ggannann/utca-rtm-8-sfp-hw/DOC/top.png

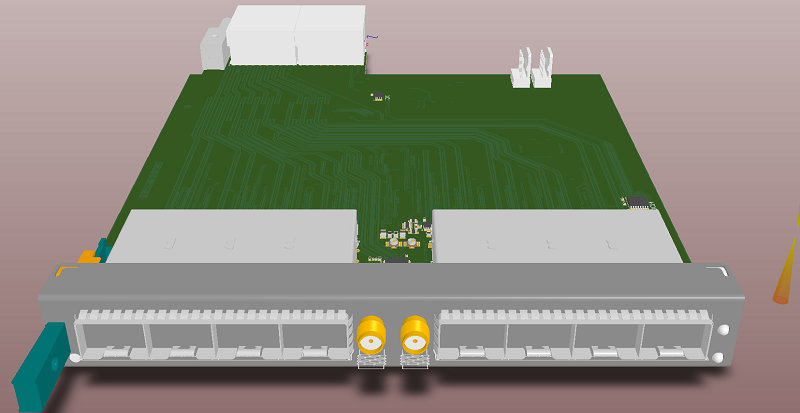
DOC/top.png
