ggannann/utca-rtm-8-sfp-hw/circuit_board/BOM_RTM_SFP.xls

Já comprado | Quantity | Comment | Description | Designator | Footprint | LibRef | Manufacturer Part Number 1 | Manufacturer1 PN | Part Description | Part Number | Value
ok | 51 | 100nF | CC0402_100NF_16V_10%_X7R | C1, C2, C3, C4, C5, C6, C7, C8, C16, C17, C18, C19, C20, C21, C22, C23, C25, C26, C27, C186A, C186B, C186C, C186D, C186E, C186F, C186G, C186H, C202A, C202B, C202C, C202D, C202E, C202F, C202G, C202H, C214A, C214B, C214C, C214D, C214E, C214F, C214G, C214H, C228A, C228B, C228C, C228D, C228E, C228F, C228G, C228H | CAPC1005X55N | 223878715649 |  |  | SMD Multilayer Chip Ceramic Capacitor | CC0402_100NF_16V_10%_X7R | 100nF
comprando | 4 | 10uF | CC1206_10UF_16V_10%_X7R | C9, C10, C12, C14 | CAPC3216X140N | C1206C106K4RAC |  |  | SMD Multilayer Chip Ceramic Capacitor | CC1206_10UF_16V_10%_X7R | 10uF
ok | 2 | 100nF | CC0603_100NF_50V_10%_X7R | C11, C280 | CAPC1608X87N | 223858615649 |  |  | SMD Multilayer Chip Ceramic Capacitor | CC0603_100NF_50V_10%_X7R | 100nF
ok | 26 | 10uF | CC0805_10UF_10V_10%_X7R | C13A, C13B, C13C, C13D, C13E, C13F, C13G, C13H, C24, C219A, C219B, C219C, C219D, C219E, C219F, C219G, C219H, C220A, C220B, C220C, C220D, C220E, C220F, C220G, C220H, C390 | CAPC2012X135N | GRM21BR71A106KE51L |  |  | SMD Multilayer Chip Ceramic Capacitor | CC0805_10UF_10V_10%_X7R | 10uF
ok | 11 | 22uF | CC1206_22UF_10V_10%_X7R | C15, C176, C179, C180, C181, C182, C207, C208, C209, C210, C213 | CAPC3216X180N | GRM31CR71A226KE15L |  |  | SMD Multilayer Chip Ceramic Capacitor | CC1206_22UF_10V_10%_X7R | 22uF
ok | 2 | 1uF | CC0603_1UF_16V_10%_X7R | C84, C386 | CAPC1608X87N | 223824613663 |  |  | SMD Multilayer Chip Ceramic Capacitor | CC0603_1UF_16V_10%_X7R | 1uF
ok | 12 | 100nF | CC0201_100NF_6.3V_10%_X5R | C391, C392, C393, C394, C395, C396, C397, C399, C400, C401, C402, C403 | CAPC0603X33N | 02016D104KAT2A |  |  | SMD Multilayer Chip Ceramic Capacitor | CC0201_100NF_6.3V_10%_X5R | 100nF
comprando | 2 | SFP+ | SFP+ 1x4 Cage (46 Pins) | Cage1, Cage2 | TYCO_2007132-1 | TYCO_2007132-1 |  |  | 1x4 Press Fit Cage For Use with SFP+ Connector (Small Form-factor Pluggable) | TYCO_2007132-1
comprando | 1 | 1.5A-15V | Fuse | F1 | FUSR_TYCO_SMD150F-2 | FUSR_TYCO_SMD150F-2 |  |  | PolySwitch® PTC Overcurrent Protection Device | FUSR_TYCO_SMD150F-2 | 1.5A-15V
comprando | 1 | 74HC04D | Hex Inverter | IC1 | SOIC127P600X175-14N | 74HC04D |  |  | Hex Inverters | 74HC04D
comprando | 4 | 74HC165D | 8-Bit Parallel-In/Serial Out Shift Register | IC2, IC5, IC7, IC9 | SOIC127P600X175-16N | 74HC165D |  |  | 8-Bit Parallel-In/Serial Out Shift Register | 74HC165D
comprando | 5 | 74HC4094D | shift register | IC3, IC4, IC6, IC8, IC10 | SO-16 | 4094
comprando | 1 | CDCLVD1212RHAT | Low Jitter, 2-Input Selectable 1:12 Universal-to-LVDS Buffer | IC11 | QFN50P600-40 | CLOCK_CDCLVD1212
comprando | 2 | LM75AIM | I2C temperature sensor | IC12, IC13 | SOIC127P600X175-8N | SENS_LM75
comprando | 1 | PCA9554DB | 8-bit I2C-bus SMBus I/O port with interrupt | IC14 | SOP65P640X120-16N | PCA9554D | NXP Semiconductors | PCA9554D,112
comprando | 1 | 24LC64-I/MS | 64K I2C Serial EEPROM | IC15 | SOP65P490X110-8N | 24LC64-I/MS |  |  | 2.5V-5.5V, 64K (8K x 8-bit) I2C Serial EEPROM | 24LC64-I/MS
comprando | 1 | TPS53126RGET | Dual Synchronous Step-Down Controller For Low Voltage Power Rails | IC16 | QFN50P400X400X100-25N-S255 | TPS53126RGET |  |  | Dual Synchronous Step-Down Controller For Low Voltage Power Rails | TPS53126RGET
comprando | 8 | nm | High-Speed Differential Line Receiver | IC20A, IC20B, IC20C, IC20D, IC20E, IC20F, IC20G, IC20H | SOT95P280X145-5N | SN65LVDS2DBVR |  |  | High-Speed Differential Line Receiver | SN65LVDS2DBVR
comprando | 1 | MAX7357ETG+ | 8-channel I2C-bus multiplexer with reset, INT and timeout | IC39 | HVQFN24 | IIC_MUX_MAX7357ETG+
comprando | 1 | FIN1101K8X | LVDS TO LVDS repeater3.3V | IC48 | US8 | IFC_FIN1101K8X
comprando | 1 | Family | Single Pin Male | J1 | TYCO_1469265-1 | TYCO_1469265-1 |  |  |  | TYCO_1469265-1
comprando | 2 | Family | Connector 60 ATCA Male 30 Pairs (60 Signals) + 3x10 Ground | J2, J6 | TYCO_6469183-1 | TYCO_6469183-1 |  |  |  | TYCO_6469183-1
comprando | 2 | SMA |  | J3, J4 | HUBER-SUHNER_85 SMA-50-0-101/111 NE | HUBER-SUHNER_85_SMA-50-0-101/111_NE |  |  | SMA 50 Ohms Right Angle PCB Jack | HUBER-SUHNER_85_SMA-50-0-101/111_NE
comprando | 8 | SFP+ | 20 Position SFP+ Connector (Small Form-factor Pluggable) | J5A, J5B, J5C, J5D, J5E, J5F, J5G, J5H | TYCO_1888247-1 | TYCO_1888247-1 |  |  | 20 Position, Pitch 0.8mm SFP+ Receptacle (Small Form-factor Pluggable) | TYCO_1888247-1
comprando | 2 | U.FL |  | J12, J13 | HIROSE_U.FL-R-SMT-1(10) | HIROSE_U.FL-R-SMT-1(10) |  |  | Up to 6GHz Ultra Small Surface Mount Male Coaxial Connectors U.FL Series | HIROSE_U.FL-R-SMT-1(10)
comprando | 2 | 1.5uH | Inductor With Magnetic core | L1, L2 | INDM6965X300N | IND2525_1.5UH_20%_VISHAY_IHLP-2525CZ |  |  | Low Profile, High Current IHLP® Inductor | IND2525_1.5UH_20%_VISHAY_IHLP-2525CZ | 1.5uH
ok | 16 | 220R@100MHz | Inductor | L5A, L5B, L5C, L5D, L5E, L5F, L5G, L5H, L11A, L11B, L11C, L11D, L11E, L11F, L11G, L11H | INDC2012X105N | IND0805_MURATA_BLM21PG221SN1D |  |  | SMD EMIFIL Suppression Chip Ferrite Bead | IND0805_MURATA_BLM21PG221SN1D | 220R@100MHz
comprando | 2 | 390R@100MHz | Inductor | L19, L20 | INDC1608X95N | IND0603_TDK_MPZ1608R391A |  |  | SMT Chip Bead for Power Line | IND0603_TDK_MPZ1608R391A | 390R@100MHz
comprando | 9 | Green | LED Green Avago C120 | LD1A, LD1B, LD1C, LD1D, LD1E, LD1F, LD1G, LD1H, LDx | LED_AVAGO_HSME-C120 | HSME-C120 |  |  | High Performance Right Angle Chip Green LED | LED_AVAGO_HSME-C120
comprando | 8 | Red | LED Red Avago C120 | LD2A, LD2B, LD2C, LD2D, LD2E, LD2F, LD2G, LD2H | LED_AVAGO_HSME-C120 | HSMC-C120 |  |  | High Performance Right Angle Chip Red LED | LED_AVAGO_HSMC-C120
comprando | 1 | Blue | LED Blue Avago C120 | LDy | LED_AVAGO_HSME-C120 | HSMR-C120 |  |  | High Performance Right Angle Chip Blue LED | LED_AVAGO_HSMR-C120
comprando | 1 | LED0603-P-RW120 or LYN971-Z | LED 0603 red | LED17 | led_0603R | LED_0603R | DIALIGHT
ok | 1 | 570BBC000121DG | Any-Rate I2C Programmable XO Oscillator Si570 Serie | OSC1 | OSC_SILICON-LAB_SI570 | OSC_10-280MHZ_SILICON-LAB_Si570BBC000121DG |  |  | 10-280MHz 3.3V ±20ppm LVDS Any-Rate I2C Programmable XO Oscillator Si570 Serie | OSC_10-280MHZ_SILICON-LAB_Si570BBC000121DG | 100MHz
comprando | 1 | Push Button | Push-Button Switch SPDT | PB1 | SW_C&K_HDT0001 | SW_C&K_HDT0001 |  |  | 5VDC 1mA SPST-NO Micro Mini Surface Surface Mount Detect Push-Button Switch, HDT Serie | SW_C&K_HDT0001
comprando | 19 | 330 | R0603_330R_1%_0.1W_100PPM | R1A, R1B, R1C, R1D, R1E, R1F, R1G, R1H, R7, R8, R9, R11A, R11B, R11C, R11D, R11E, R11F, R11G, R11H | RESC1608X55N | NRC06F3300TRF |  |  | General Purpose Thick Film Chip Resistor | R0603_330R_1%_0.1W_100PPM | 330
 | 6 | 100k | RES SMD 100K OHM 0.1% 1/16W 0603 | R2, R3, R4, R5, R6, R13 | RESC1608X55N | RN73C1J100KBTDF | TT Electronics/Welwyn | PCF0603R-100KBT1 | General Purpose Thick Film Chip Resistor | RES SMD 100K OHM 0.1% 1/16W 0603 | 100k
comprando | 16 | 100 | R0603_100R_1%_0.1W_100PPM | R105A, R105B, R105C, R105D, R105E, R105F, R105G, R105H, R109A, R109B, R109C, R109D, R109E, R109F, R109G, R109H | RESC1608X55N | NRC06F4700TRF |  |  | General Purpose Thick Film Chip Resistor | R0603_100R_1%_0.1W_100PPM | 100
ok | 40 | 10k | R0603_10K_1%_0.1W_100PPM | R10A, R10B, R10C, R10D, R10E, R10F, R10G, R10H, R12A, R12B, R12C, R12D, R12E, R12F, R12G, R12H, R400A, R400B, R400C, R400D, R400E, R400F, R400G, R400H, R403A, R403B, R403C, R403D, R403E, R403F, R403G, R403H, R404A, R404B, R404C, R404D, R404E, R404F, R404G, R404H | RESC1608X55N | NRC06F1002TRF |  |  | General Purpose Thick Film Chip Resistor | R0603_10K_1%_0.1W_100PPM | 10k
ok | 29 | 10k | R0402_10K_1%_0.0625W_100PPM | R14, R15, R16, R28, R30, R31, R32, R311, R316, R317, R318, R319, R320, R321, R322, R323, R324, R325, R326, R327, R328, R329, R330, R331, R332, R333, R334, R335, R336 | RESC1005X40N | 232270671003L |  |  | General Purpose Thick Film Chip Resistor | R0402_10K_1%_0.0625W_100PPM | 10k
comprando | 2 | 6k8 1% | R0603_6K8_1%_0.1W_100PPM | R17, R195 | 0603R | NRC06F6801TRF |  |  | General Purpose Thick Film Chip Resistor | R0603_6K8_1%_0.1W_100PPM | 6k8
comprando | 2 | 1k3 1% | R0603_1K3_1%_0.1W_100PPM | R18, R54 | 0603R | NRC06F1301TRF |  |  | General Purpose Thick Film Chip Resistor | R0603_1K3_1%_0.1W_100PPM | 1k3
comprando | 4 | 1M | R1206_1M_1%_0.25W_100PPM | R19, R20, R21, R22 | RESC3216X65N | NRC12F1004TRF |  |  | General Purpose Thick Film Chip Resistor | R1206_1M_1%_0.25W_100PPM | 1M
ok | 6 | 5k1 | R0603_5K1_1%_0.1W_100PPM | R23, R24, R25, R26, R27, R246 | RESC1608X55N | NRC06F5101TRF |  |  | General Purpose Thick Film Chip Resistor | R0603_5K1_1%_0.1W_100PPM | 5k1
comprando | 4 | 100R | R0603_5K1_1%_0.1W_100PPM | R33, R34, R35, R36 | RESC1608X55N | NRC06F5101TRF |  |  | General Purpose Thick Film Chip Resistor | R0603_5K1_1%_0.1W_100PPM | 100R
comprando | 1 | 4k3 1% | R0603_4K3_1%_0.1W_100PPM | R53 | 0603R | NRC06F4301TRF |  |  | General Purpose Thick Film Chip Resistor | R0603_4K3_1%_0.1W_100PPM | 4k3
comprando | 8 | 0 | R0603_0R_JUMPER | R107A, R107B, R107C, R107D, R107E, R107F, R107G, R107H | RESC1608X55N | NRC06Z0 |  |  | 1A (0.05R Max DC Resistance) Zero Ohm Jumper | R0603_0R_JUMPER | 0
ok | 1 | 51R | SMD Resistor | R211 | 0402R | CRCW04021K00JNED | VISHAY
comprando | 1 | 3k0 1% | R0603_3K_1%_0.1W_100PPM | R248 | 0603R | NRC06F3001TRF |  |  | General Purpose Thick Film Chip Resistor | R0603_3K_1%_0.1W_100PPM | 3k
ok | 4 | 49R9 | R0402_49R9_1%_0.0625W_100PPM | R312, R313, R314, R315 | RESC1005X40N | 232270674999L or RC0402FR-0749R9L |  |  | General Purpose Thick Film Chip Resistor | R0402_49R9_1%_0.0625W_100PPM | 49R9
comprando | 1 | 4k3 | R0603_4K3_1%_0.1W_100PPM | R391 | RESC1608X55N | NRC06F4301TRF |  |  | General Purpose Thick Film Chip Resistor | R0603_4K3_1%_0.1W_100PPM | 4k3
ok | 16 | BSS138LT1G | N-CHANNEL MOSFET WITH DIODE | T1A, T1B, T1C, T1D, T1E, T1F, T1G, T1H, T2A, T2B, T2C, T2D, T2E, T2F, T2G, T2H | SOT95P240X110-3N | BSS138LT1G |  |  | 50V 200mA N-Channel Enhancement Mode Field-Effect Transistor | BSS138LT1G
comprando | 2 | IRF9910Pbf | Dual SO-8 MOSFET For POL Cconverter | T5, T6 | SOIC127P600X175-8N | IRF9910Pbf |  |  | 20V 10A(Q1) 20V 12A (Q2) Dual SO-8 MOSFET For POL Cconverter | IRF9910Pbf
