ggannann/utca-rtm-8-sfp-hw/DOC/SCH_uTCA_SFP.PDF

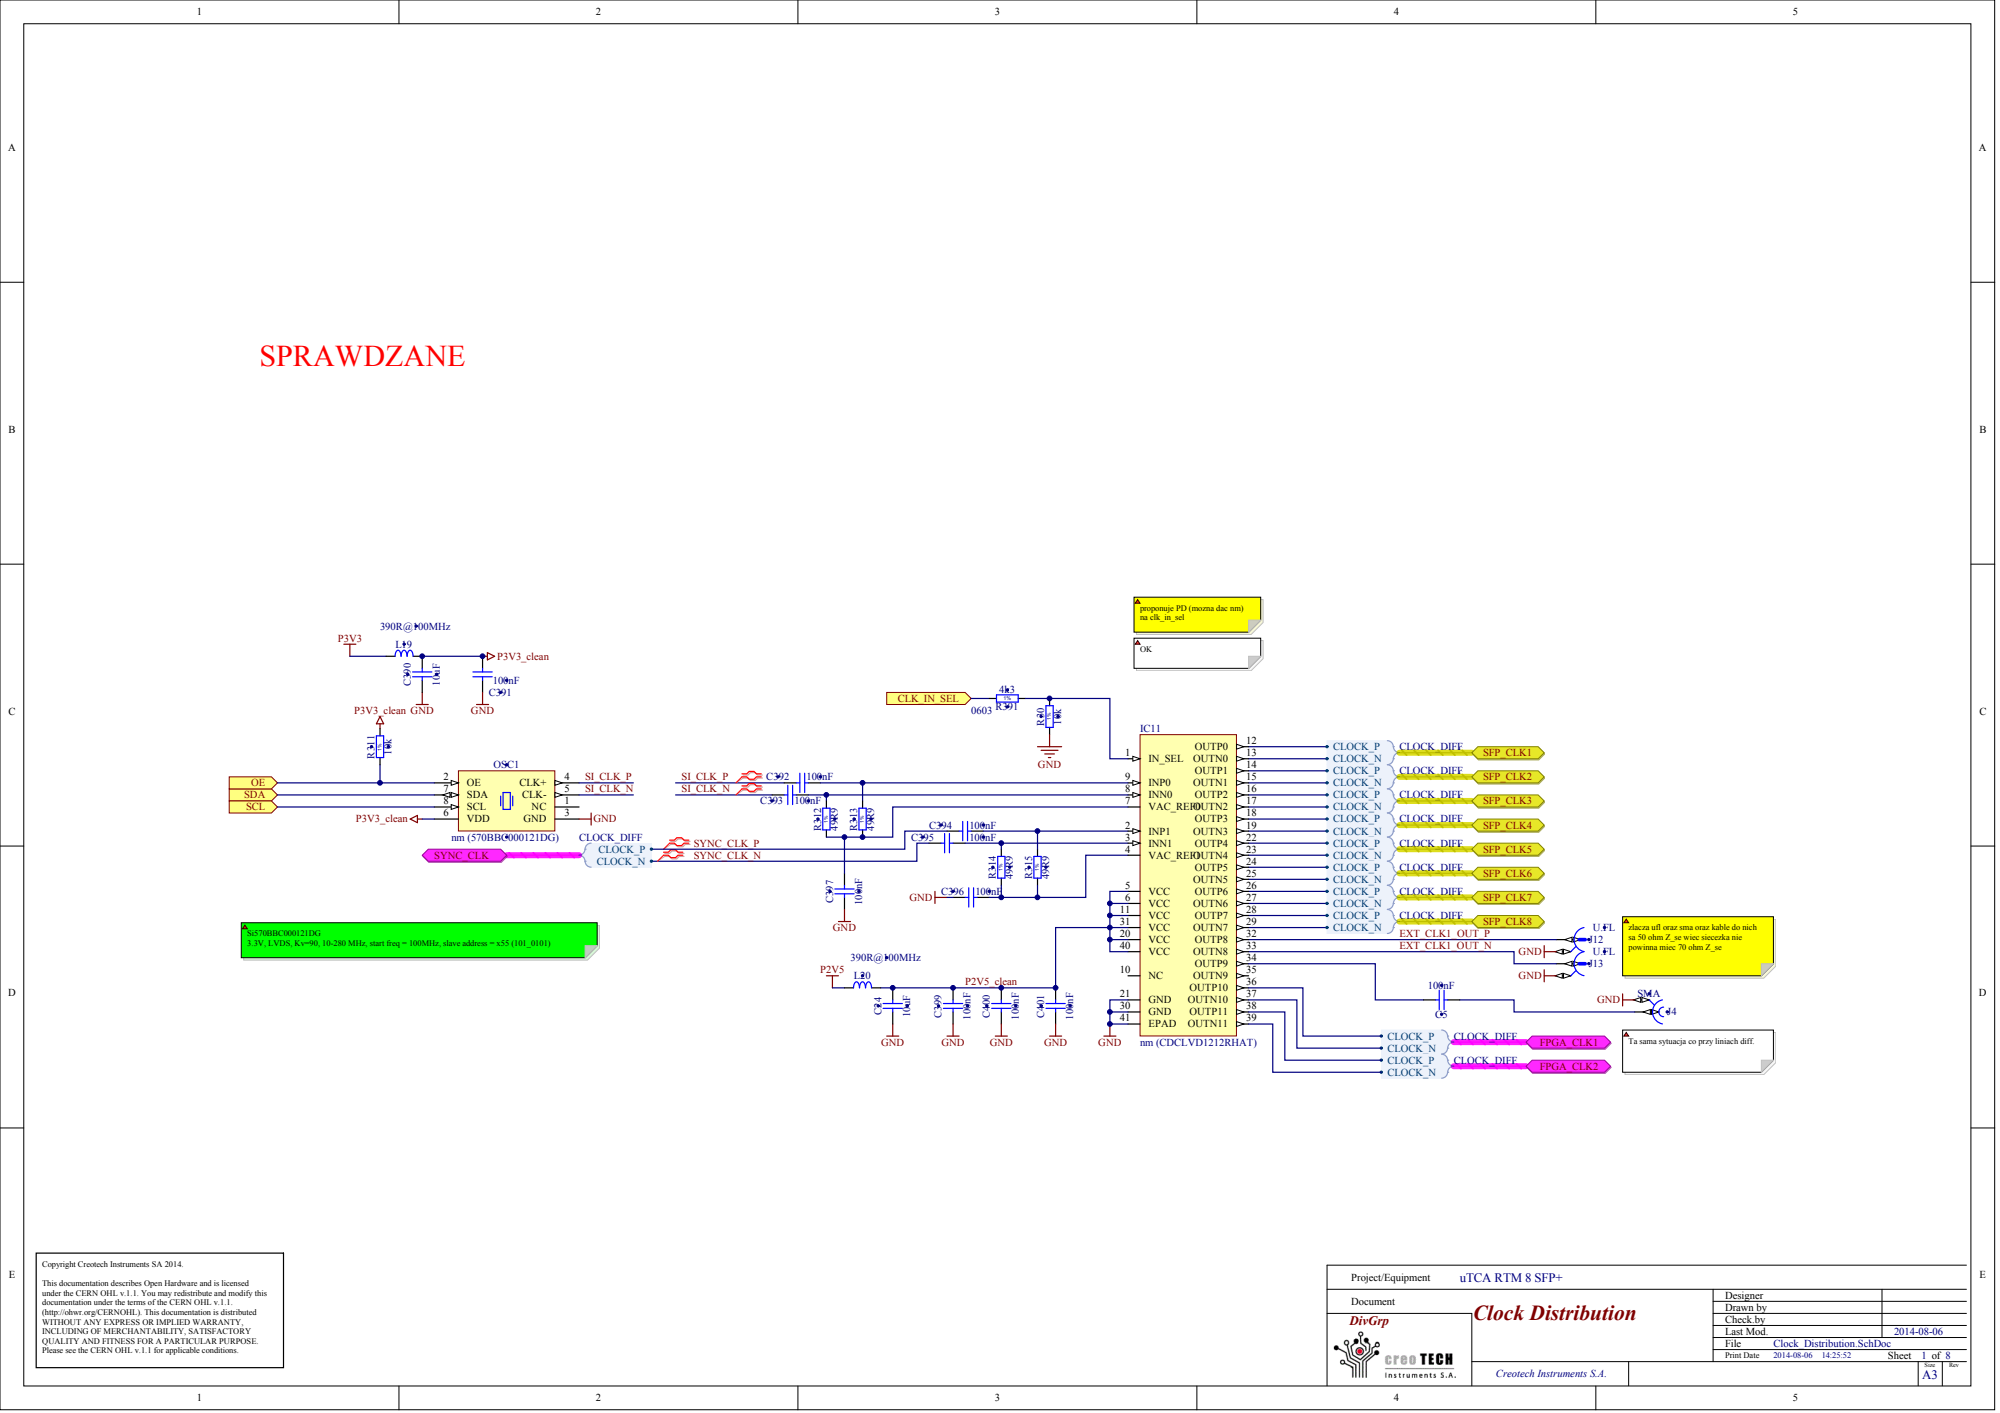
[picture p2: page 1]

proponuje PD (mozna dac nm)
na clk_in_se

OE VDD | CL K+ GND

VCC 11

zlacza ufl oraz sma oraz kabl
sa 50 ohm Z_se wiec siecezka nie
powinna miec 70 ohm Z_se

VCC 20

v=90, 10-280 MHz, start freq = 100MHz, slav

Ta sama sytuacja co przy liniach diff.

This documentation describes Open Hardware and is licensed
under the CERN OHL v.1.1. You may redistribute and modify this
documentation under the terms of the CERN OHL v.1.1.
(http://ohwr.org/CERNOHL). This documentation is distributed WITHOUT ANY EXPRESS OR IMPLIED WARRANTY, INCLUDING OF MERCHANTABILITY, SATISFACTORY

e the CERN OHL v.1.1 for applicabl

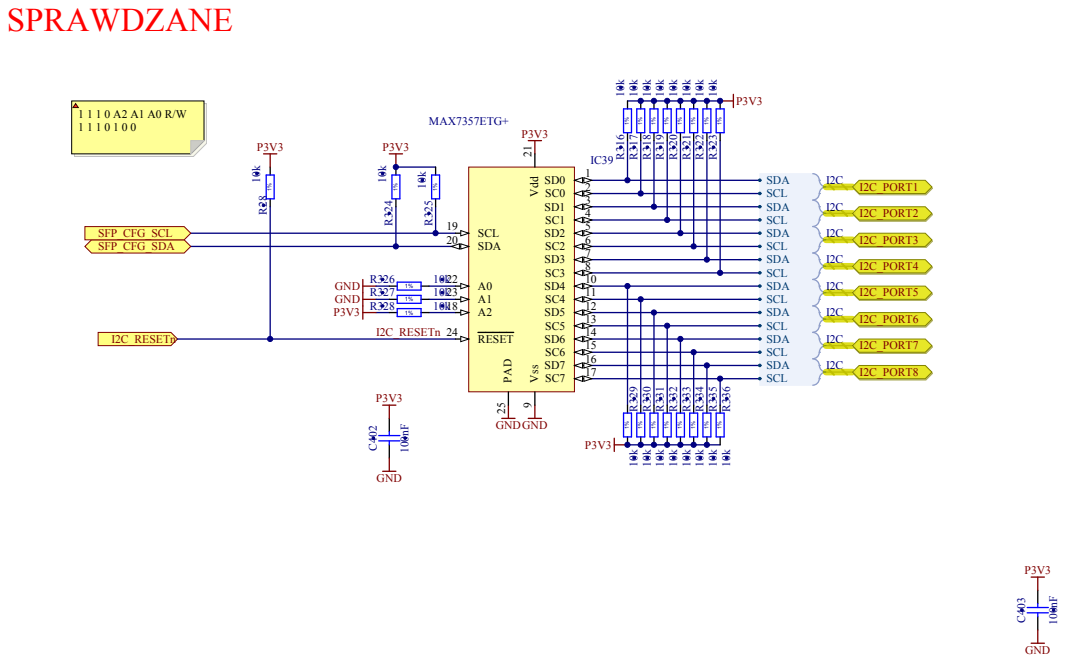
[picture p3: page 2]

This documentation describes Open Hardware and is licensed

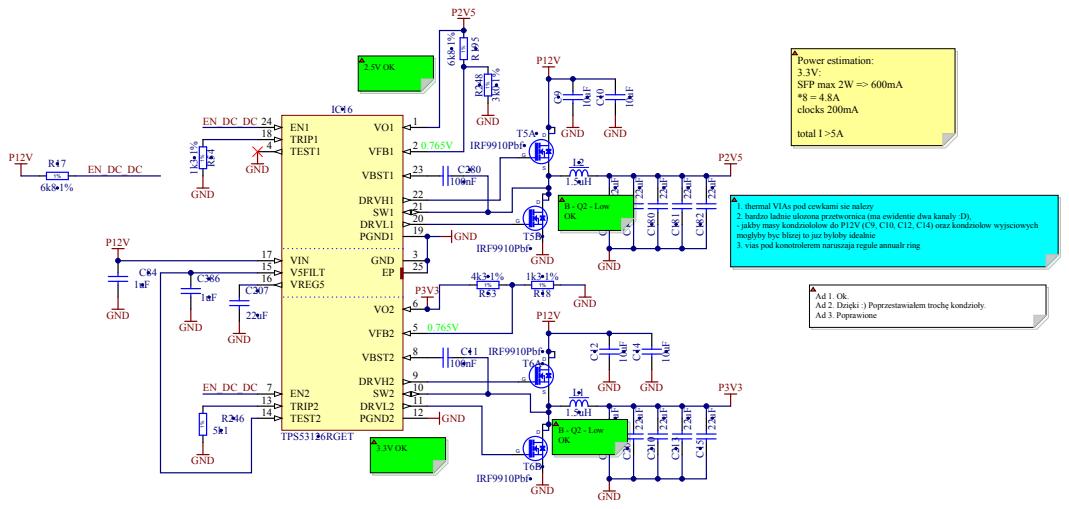
[picture p4: page 3]

1. thermal VIAs pod cewkami sie nal
2. bardzo ladnie ul
- jakby masy kondzio
yby byc blizej to juz by
3. vias pod konotro

ow do P12V (C9, C10, C12, C14) oraz kondzio

This documentation describes Open Hardware and is licensed

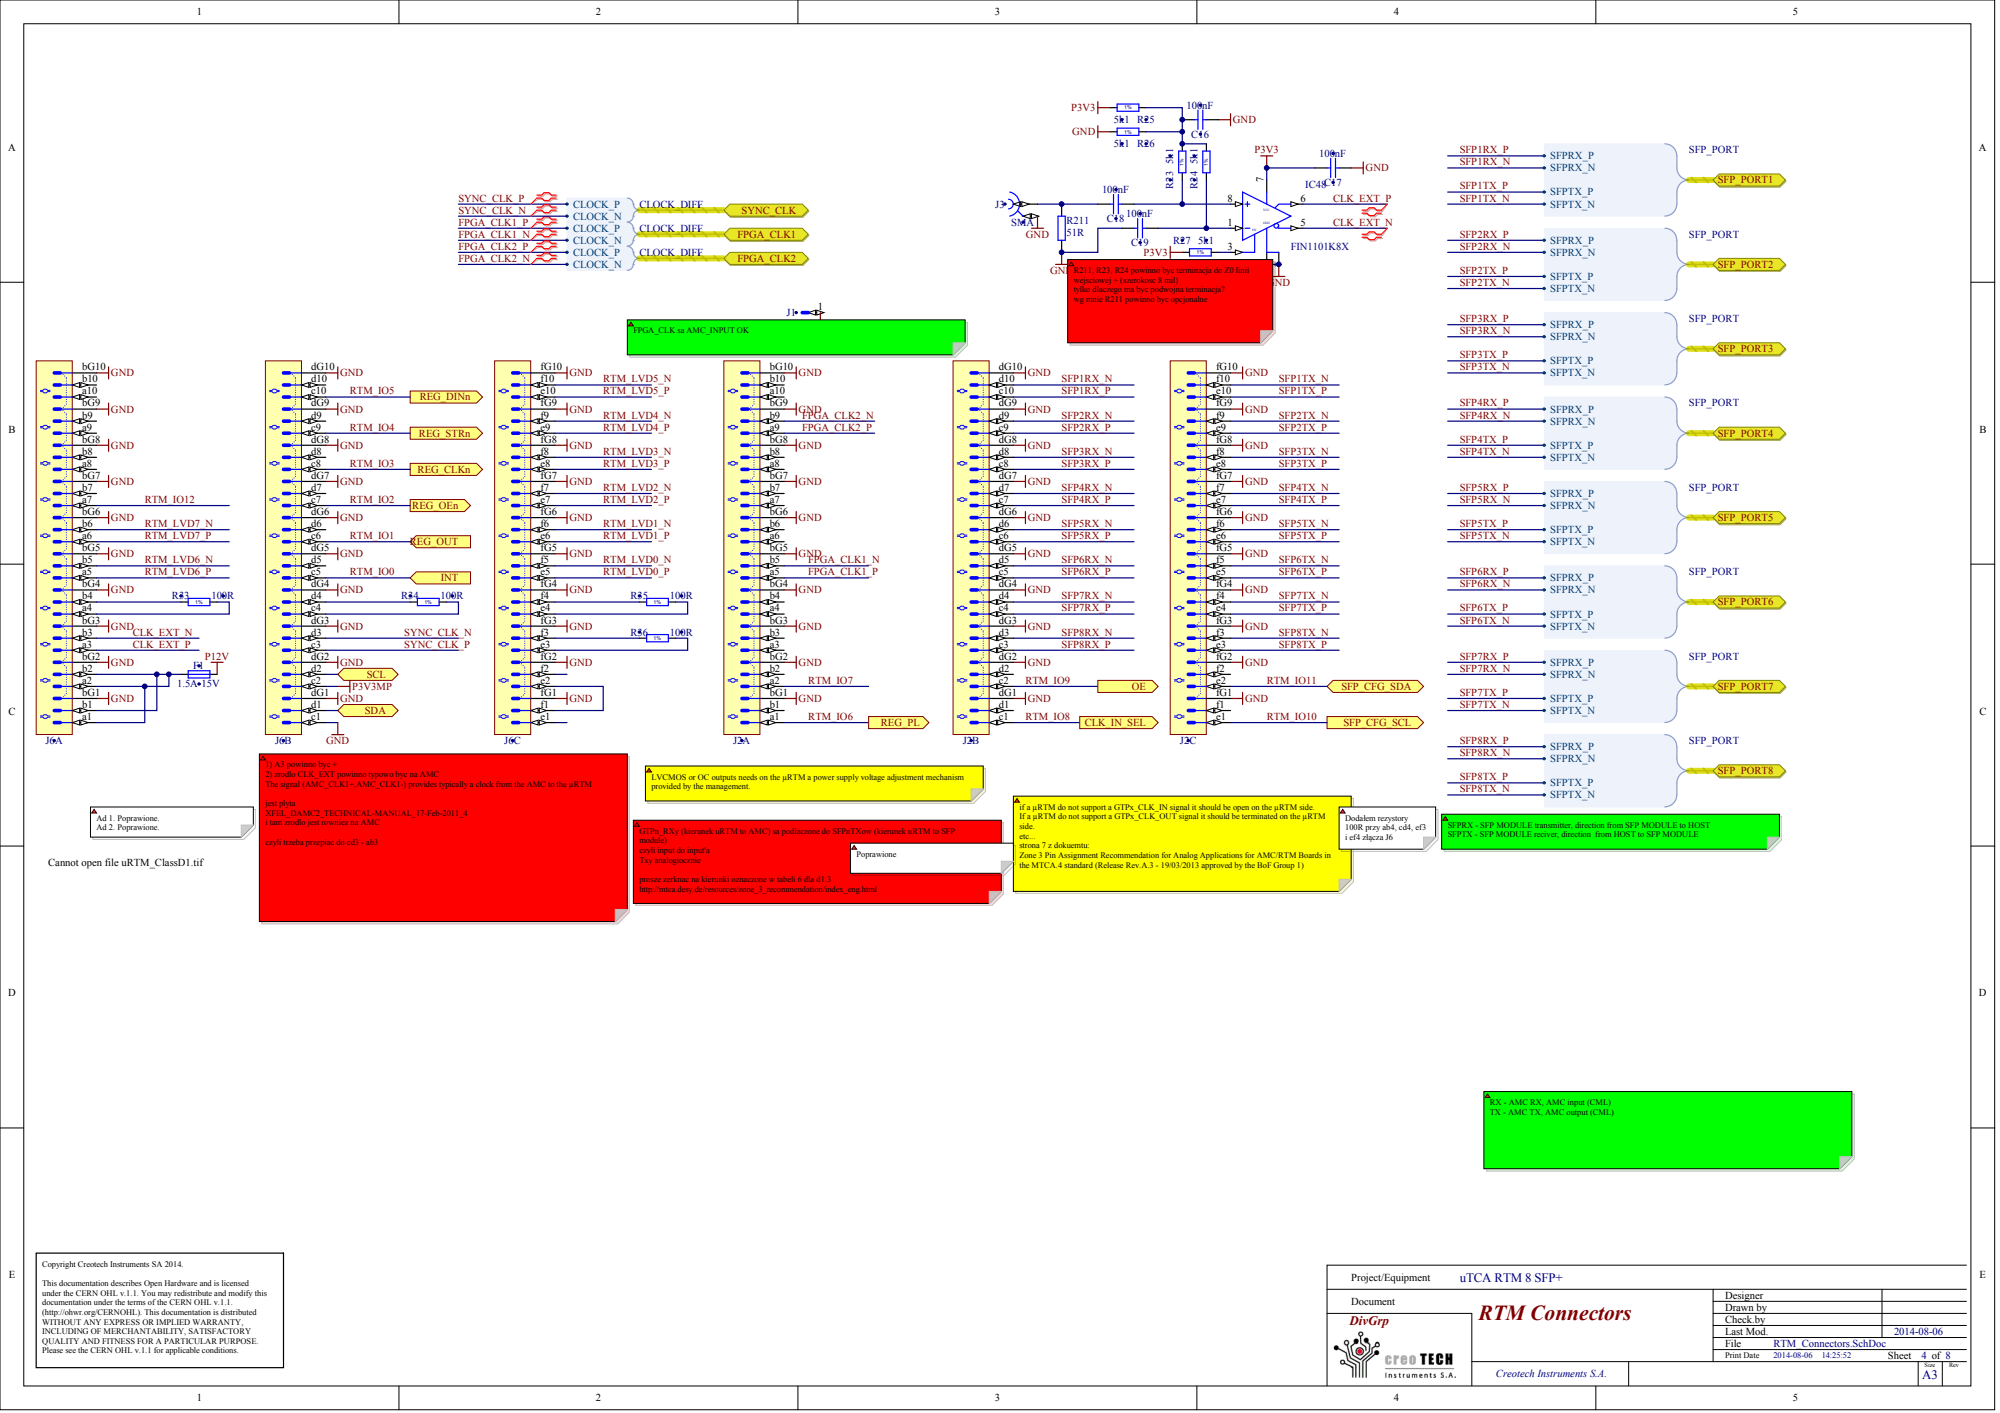
[picture p5: page 4]

R211, R23, R24 powinno byc terminacja do Z0 linii
wejsciowej + (szerokosc 8 mil
lko dlacze
wg mnie R211 powinno byc opcjonalne

o ma byc podwojna terminacja?

K_EXT powinno typowo byc na AMC

LVCMOS or OC outputs ne
vided by the manag
pro

eds on the µRTM a power suppl
ement.

ock from the AMC to the µRTM

if a µRTM do not support a G
If a µRTM do not support a G
side
etc...
strona 7 z dokuemtu: Zone 3 Pin Assignment Recommendation for Anal

K_IN signal it should be open on the µRTM side
K_OUT signal it should be terminated on the µRTM

o jest rowniez na AMC

SFPRX - SFP MODULE transmitter, direction from SFP MODULE to HOST
SFPTX - SFP MODULE reciv

TPn_RXy (kierunek uRTM to AMC) sa podlaczone do SFPnTXow (kierunek uRTM to SFP
modul
li input do input'a
czy
Txy anal

er, direction from HOST to SFP MODUL

li trzeba przepiac do cd3 - ab3

g Applications for AMC/RTM Boards in

Cannot open file uRTM_ClassD1.tif

the MTCA.4 standard (Re

ed by the Bo

prosze zerknac na kierunki oznaczone w tabe
http://mtca.desy.de/resources/zone_3_recommendation/index_eng.html

RX - AMC RX, AMC input (CML
TX - AMC TX, AMC output (CML

This documentation describes Open Hardware and is licensed

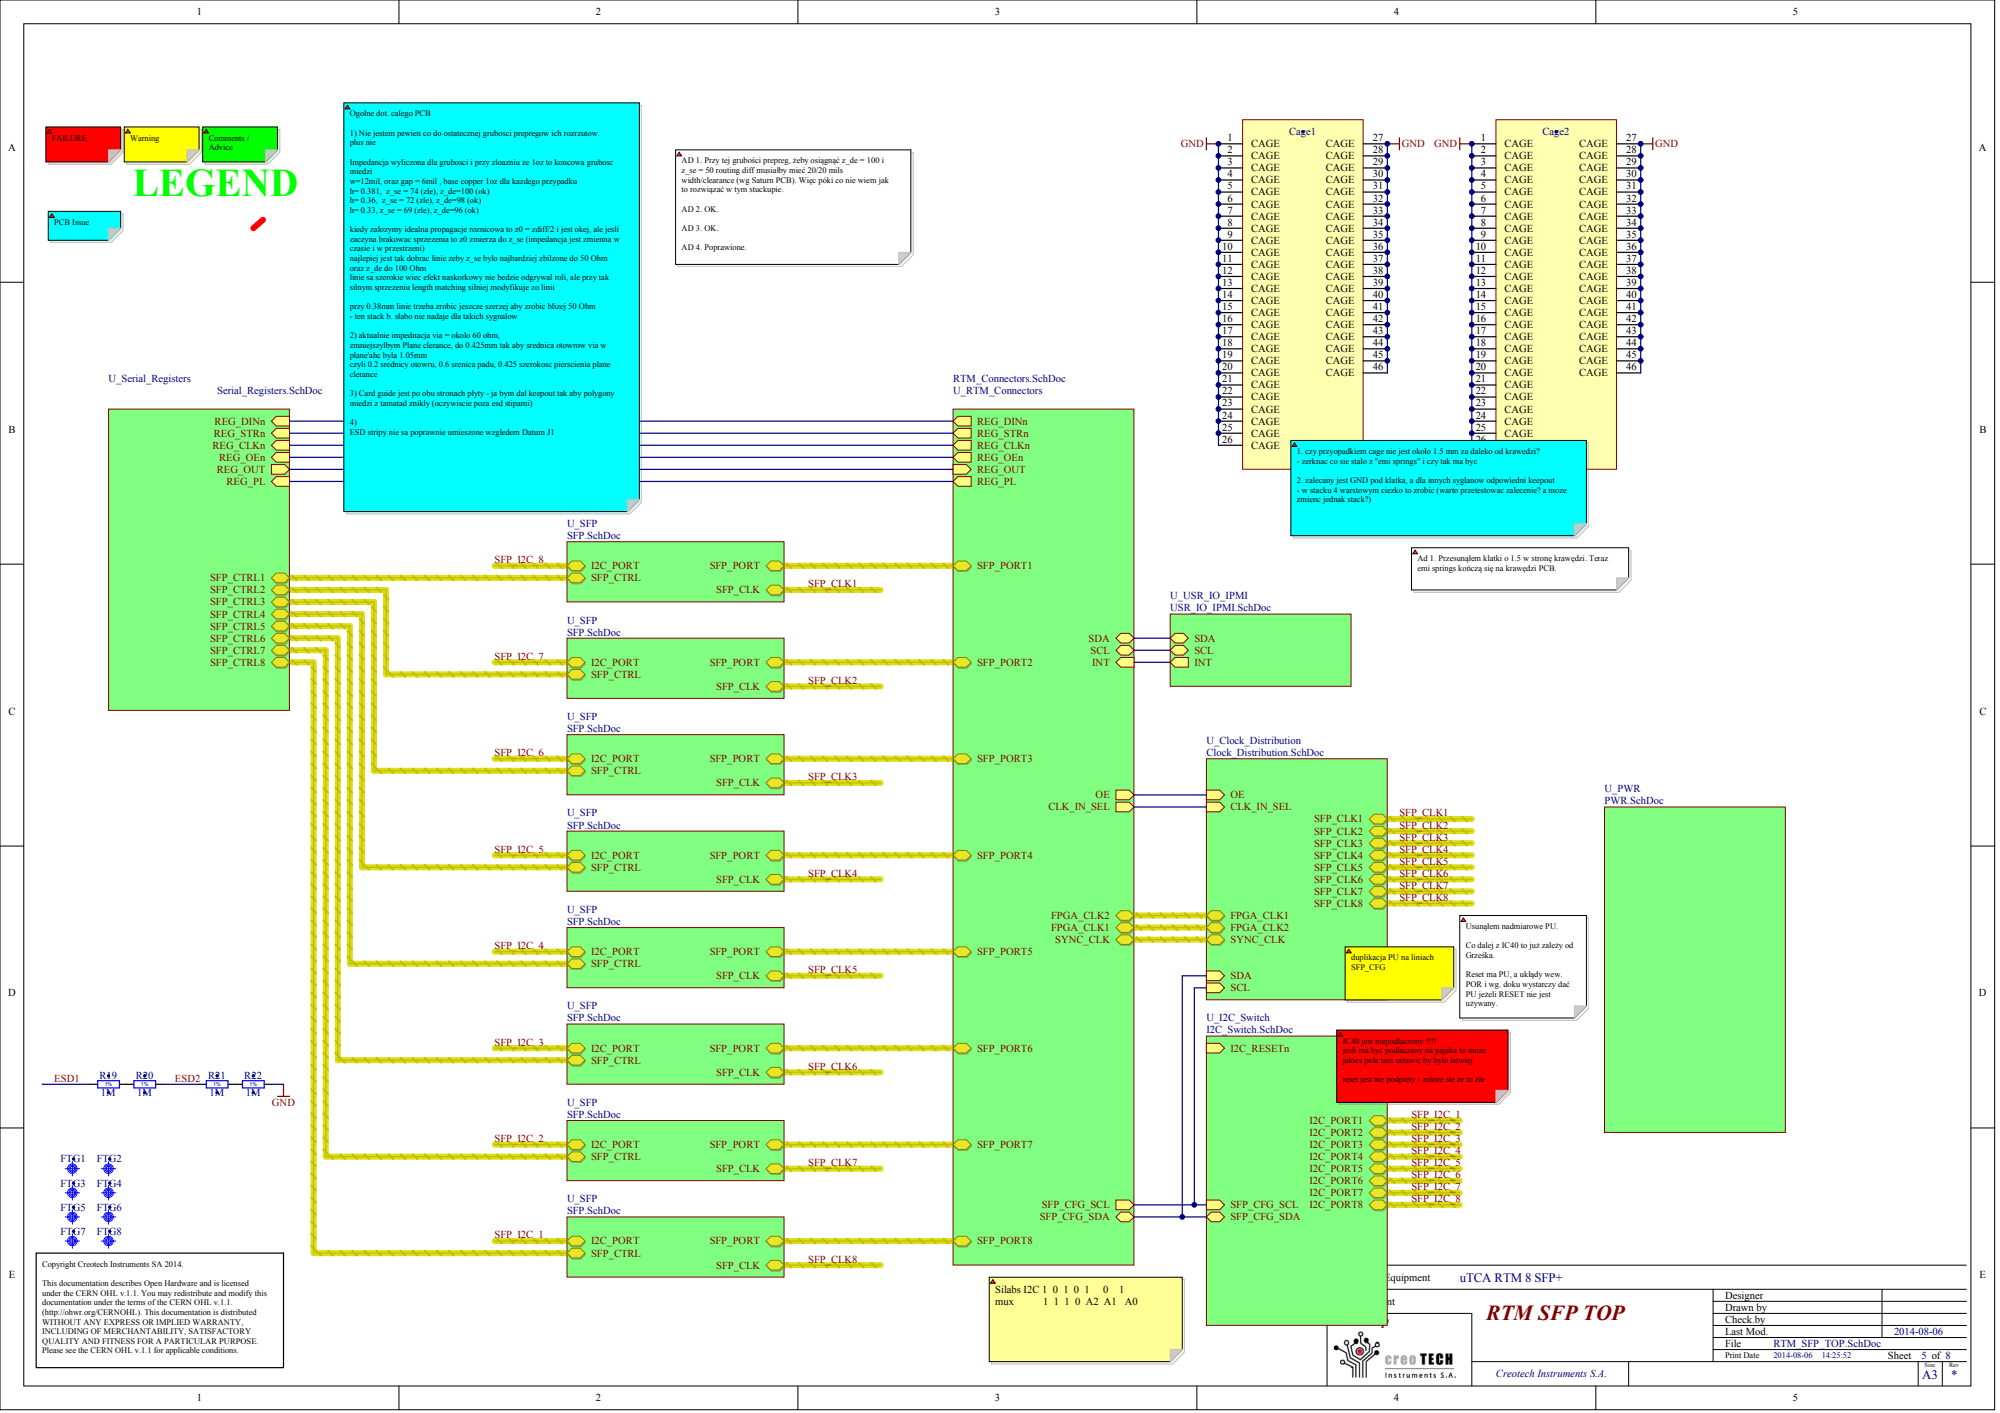
[picture p6: page 5]

1) Nie jestem pewien co do ostatecznej grubosci prepre
plus nie Impedancja wy

liczona dla grubosci i przy zl

oazniu ze 1oz to koncowa grubosc

AD 1. Przy tej grubo
z_se = 50 routing diff musia
width/cl
to rozwi

miedzi
w=12mil, oraz gap = 6mil , base copper 1oz dla kazde

earance (wg Saturn PCB). W
ć w tym stuckupie
ąza

kiedy zal
zaczyna brakowac sprzezenia to z0 zmierza do z_se (impedancja jest zmienna w
czasie i w przestrzeni)
najl
oraz z_de do 100 Ohm linie sa szerokie wiec efekt naskorkowy nie bedzie odgrywal ro

ozymy idealna propagacje roznicowa to z0 = zdiff/2 i jest okej, al

epiej jest tak dobrac linie zeby z_se by

o najbardziej zbilzone do 50 Ohm

ength matching silniej modyfikuje zo linii

przy 0.38mm linie trzeba zrobic jeszcze szerzej aby zrobic blizej 50 Ohm
- ten stack b. s

łabo nie nadaje dla takich sy

2) aktualnie impednacja via = oko
zmniejszy
plane'ahc by
li 0.2 srednicy otowru, 0.6 srenica padu, 0.425 szerokosc pierscienia plane
czy
erance

erance, do 0.425mm tak aby srednica otowrow via w

3) Card guide jest po obu stronach p
miedzi z tamatad znikl

łyty - ja bym dal ke

epout tak aby po

y (oczywiscie poza esd stipami)

ESD stripy nie sa poprawnie umieszone wzg

opadkiem cag
- zerknac co sie stal

e nie jest oko
o z "emi springs" i czy tak ma by

ecany jest GND pod klatka, a dla innych sy
2. zal
- w stacku 4 warstowym ciezko to zrobic (warto przetestowac zal
zmienc jednak stack?

duplikacja PU na liniach
SFP_CF

Reset ma PU, a uk
POR i wg. doku wystarczy da

IC40 jest niepodlaczony !
jesli ma byc podlaczany na pajaka to moze
jakies po

la tam ustawic by by

reset jest nie podpiety - zal

oze sie ze to zl

This documentation describes Open Hardware and is licensed

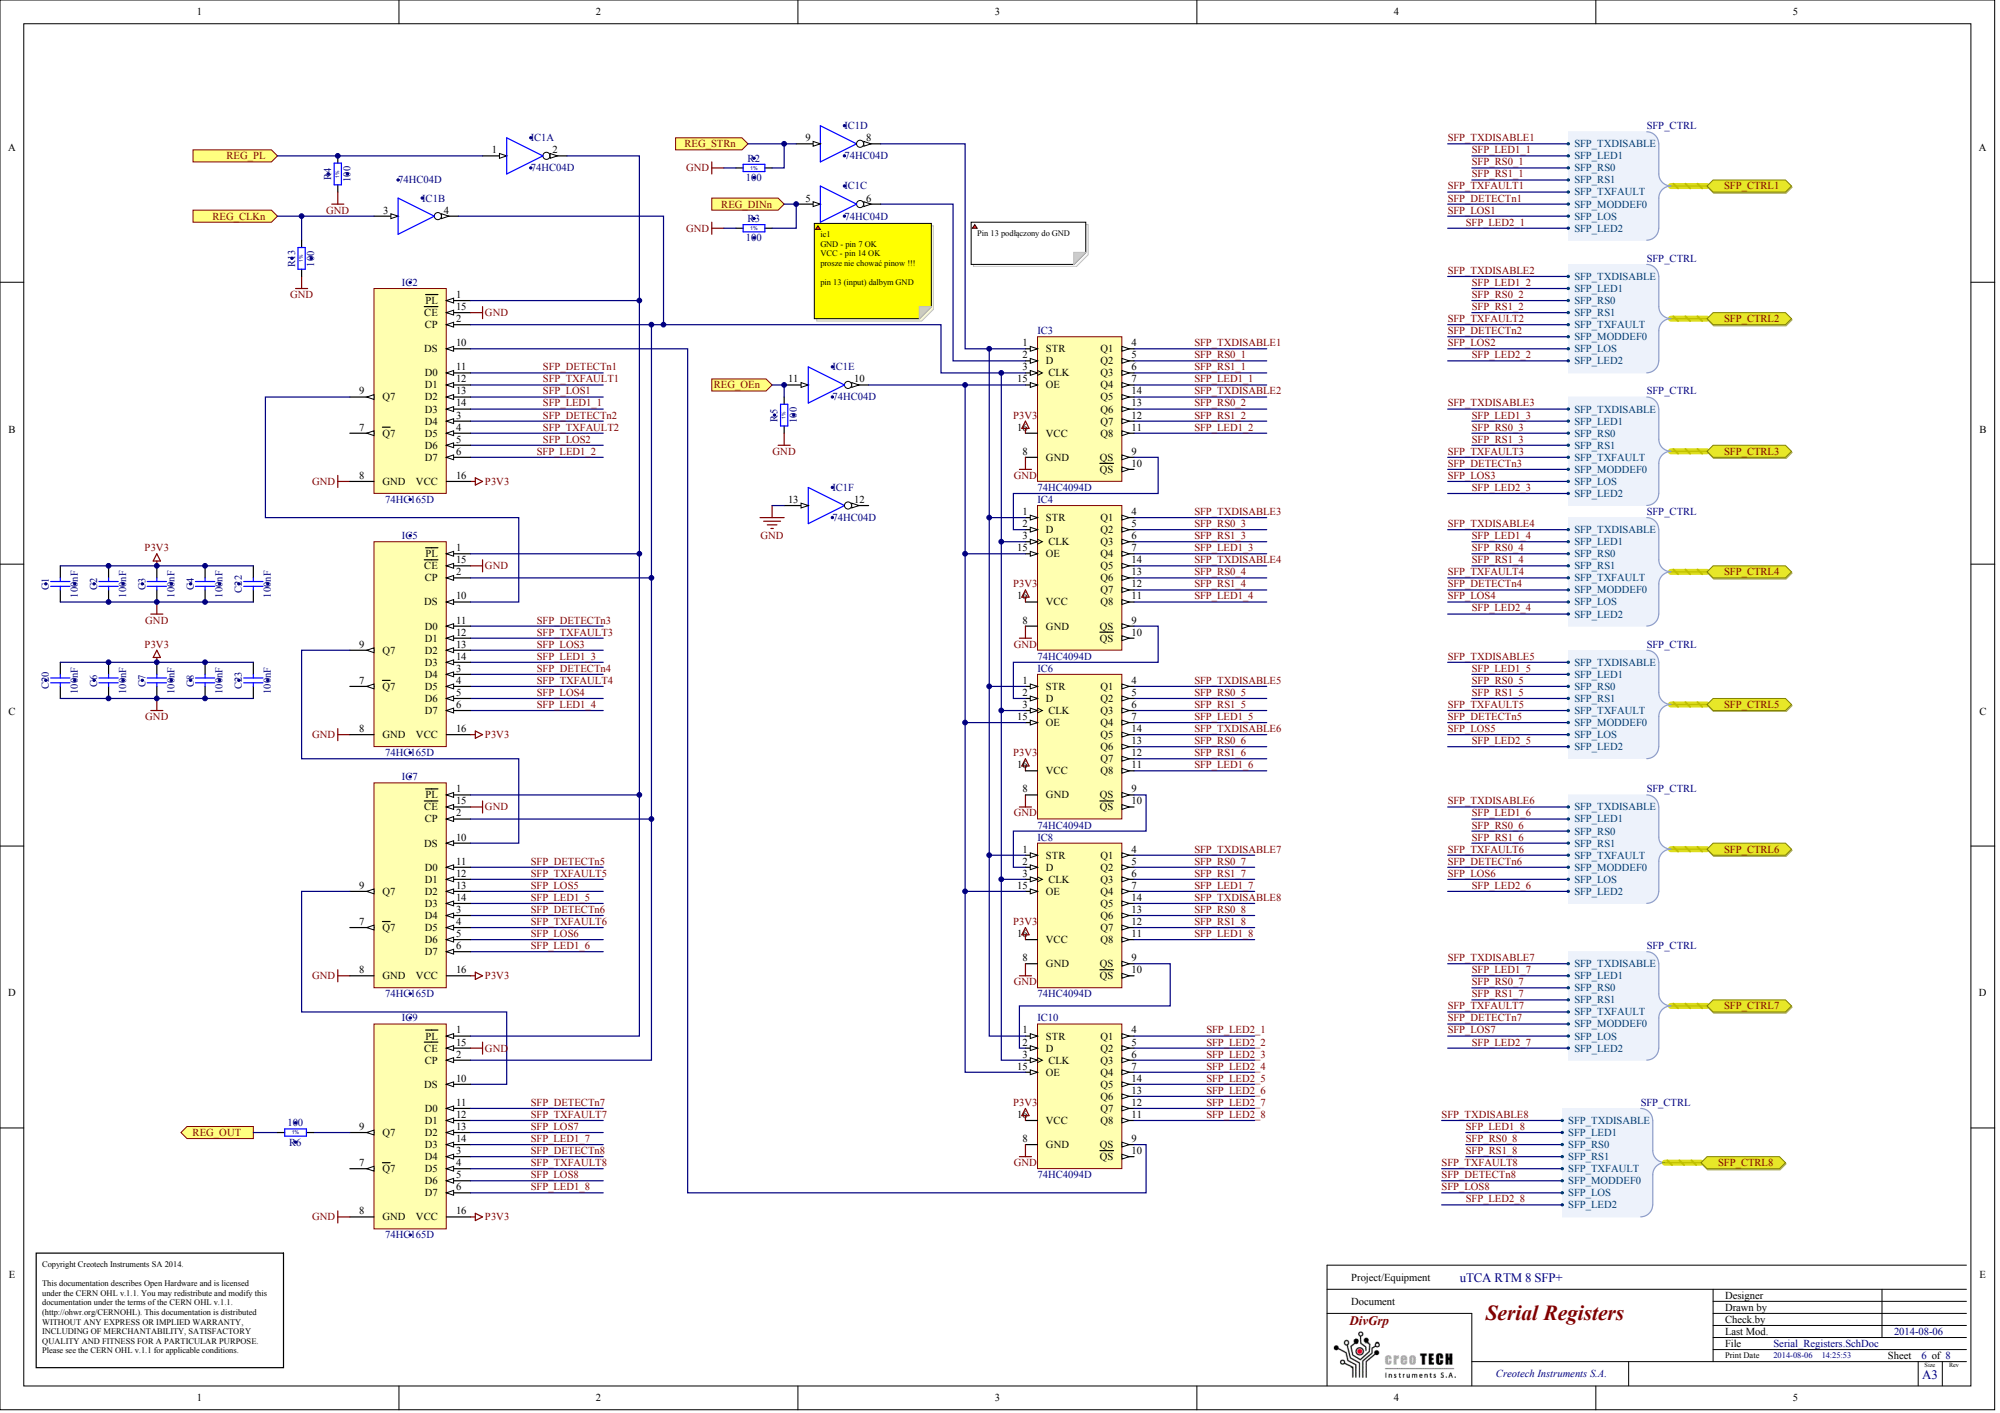
[picture p7: page 6]

pin 13 (input) dalbym GND

OE 15 VCC 16

This documentation describes Open Hardware and is licensed

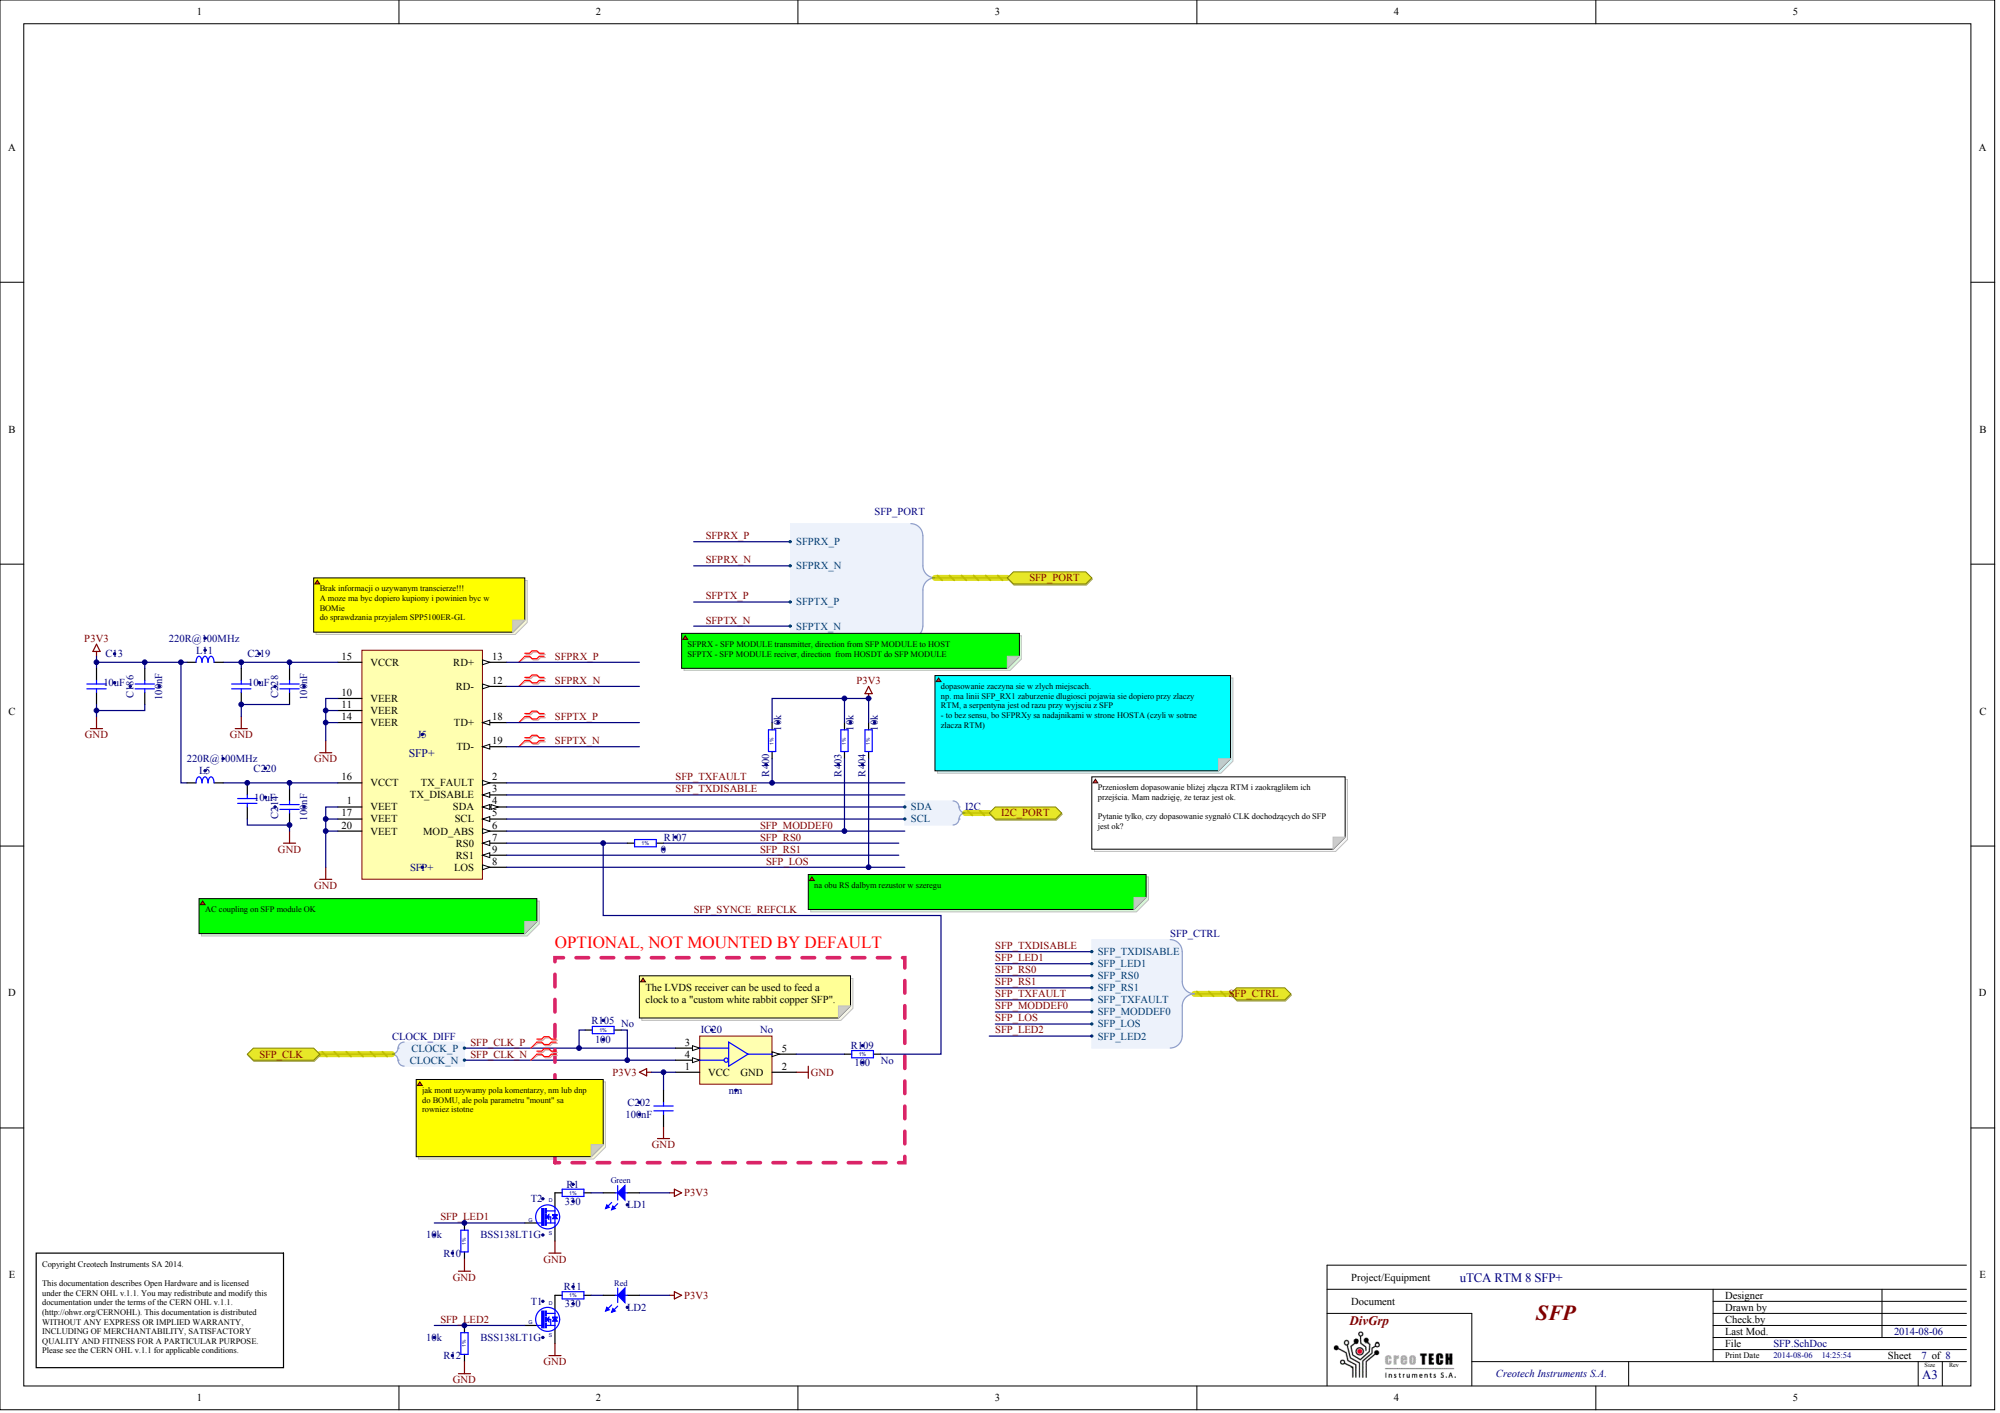
[picture p8: page 7]

Brak informacji o uzywanym transcierze!!!
A moze ma byc dopiero kupiony i powinien byc w
BOMie
do sprawdzania przyjalem SPP5100ER-GL

SFPRX - SFP MODULE transmitter, direction from SFP MODULE to HOST
SFPTX - SFP MODULE reciver, direction from HOSDT do SFP MODULE

dopasowanie zaczyna sie w zlych miejscach.
np. ma linii SFP_RX1 zaburzenie dlugiosci pojawia sie dopiero przy zlaczy
RTM, a serpentyna jest od razu przy wyjsciu z SFP
- to bez sensu, bo SFPRXy sa nadajnikami w strone HOSTA (czyli w sotrne
zlacza RTM)

Przeniosłem dopasowanie bliżej złącza RTM i zaokrągliłem ich
przejścia. Mam nadzięję, że teraz jest ok.

VEET 17

Pytanie tylko, czy dopasowanie sygnałó CLK dochodzących do SFP
jest ok?

SFP_MODDEF0

na obu RS dalbym rezustor w szeregu

AC coupling on SFP module OK

OPTIONAL, NOT MOUNTED BY DEFAULT

The LVDS receiver can be used to feed a
clock to a "custom white rabbit copper SFP".

jak mont uzywamy pola komentarzy, nm lub dnp
do BOMU, ale pola parametru "mount" sa
rowniez istotne

Copyright Creotech Instruments SA 2014.

This documentation describes Open Hardware and is licensed

(http://ohwr.org/CERNOHL). This documentation is distributed
WITHOUT ANY EXPRESS OR IMPLIED WARRANTY,
INCLUDING OF MERCHANTABILITY, SATISFACTORY
QUALITY AND FITNESS FOR A PARTICULAR PURPOSE.
Please see the CERN OHL v.1.1 for applicable conditions.

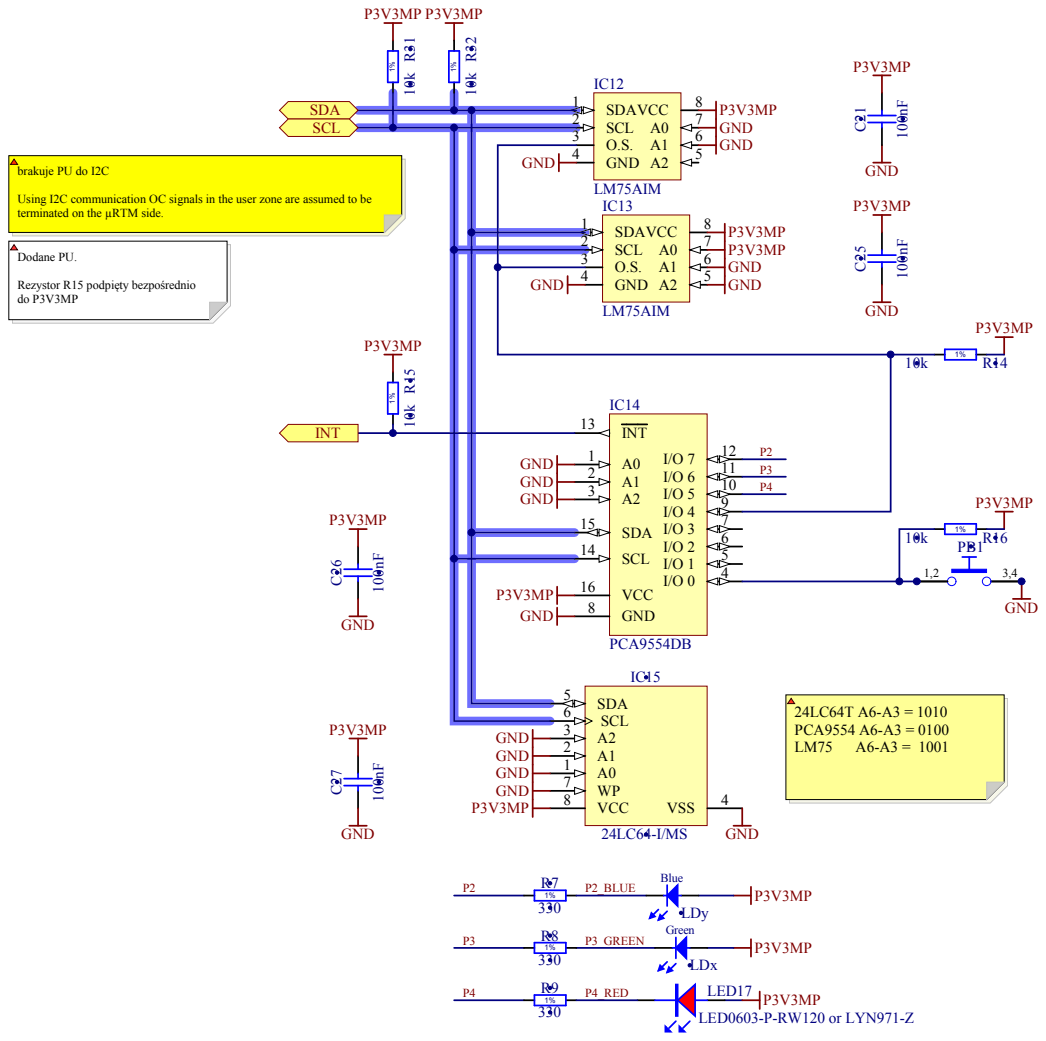
[picture p9: page 8]

Using I2C communication OC signals in the user zone are assumed to be
terminated on the µRTM side.

Copyright Creotech Instruments SA 2014.

This documentation describes Open Hardware and is licensed

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
