ggannann/utca-rtm-8-sfp-hw/DOC/PCB_uTCA_SFP.PDF

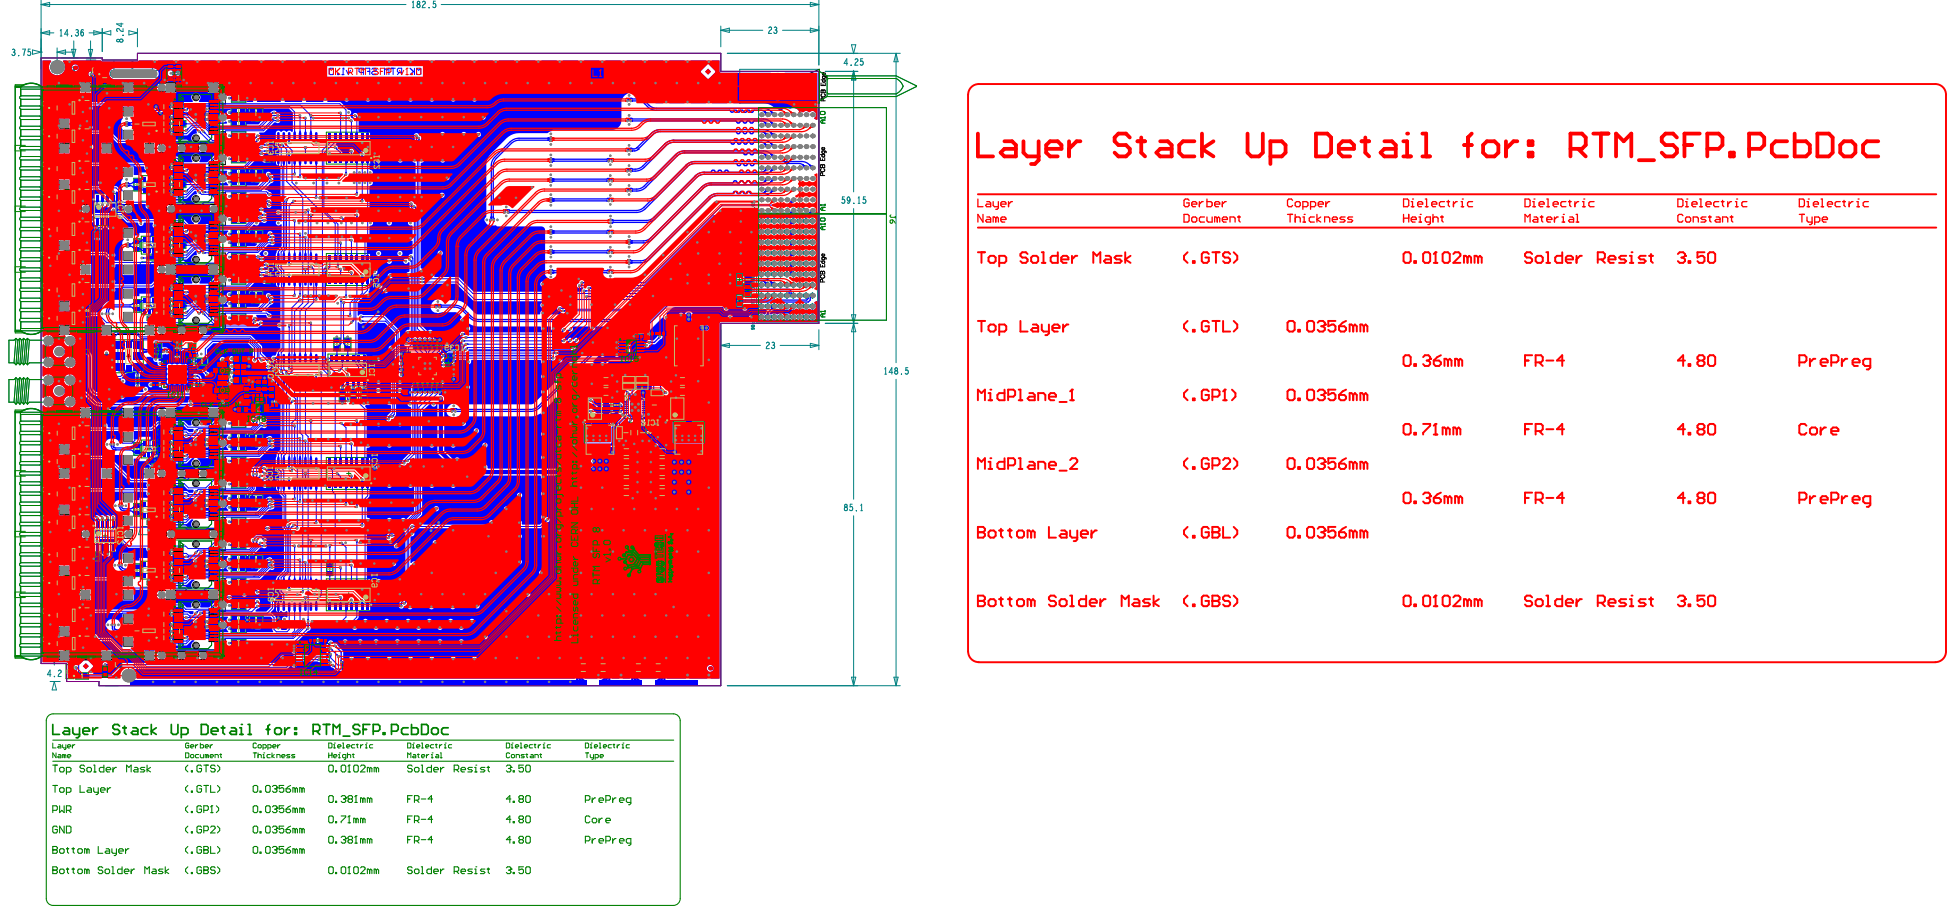
[picture p10: page 1]
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
