ggannann/utca-rtm-8-sfp-hw/(list of files, drawings)

Other design files:
circuit_board/Clock_Distribution.SchDoc
circuit_board/I2C_Switch.SchDoc
circuit_board/PWR.SchDoc
circuit_board/RTM_Connectors.SchDoc
circuit_board/RTM_SFP.PrjPcb
circuit_board/RTM_SFP_TOP.SchDoc
circuit_board/Serial_Registers.SchDoc
circuit_board/SFP.SchDoc
circuit_board/USR_IO_IPMI.SchDoc
