ggannann/utca-rtm-8-sfp-hw/(commit log)

2013-10-25 init repo
    [Clock_Distribution.SchDoc, I2C_Switch.SchDoc, PWR.SchDoc, RTM_Connectors.SchDoc, RTM_SFP.PrjPcb, RTM_SFP_TOP.SchDoc, SFP.SchDoc, Serial_Registers.SchDoc]
2013-11-01 PCB layout finished
    [Clock_Distribution.SchDoc, I2C_Switch.SchDoc, PWR.SchDoc, RTM_Connectors.SchDoc, RTM_SFP.PrjPcb, RTM_SFP_TOP.SchDoc, SFP.SchDoc, Serial_Registers.SchDoc]
2013-11-04 final PCB ready for review
2013-11-16 final PCB modified project structure
    [Clock_Distribution.SchDoc, I2C_Switch.SchDoc, PWR.SchDoc, RTM_Connectors.SchDoc, RTM_SFP.PrjPcb, RTM_SFP_TOP.SchDoc, SFP.SchDoc, Serial_Registers.SchDoc]
2013-11-16 new project structure
    [Clock_Distribution.SchDoc, I2C_Switch.SchDoc, PWR.SchDoc, RTM_Connectors.SchDoc, RTM_SFP_TOP.SchDoc, SFP.SchDoc, Serial_Registers.SchDoc, USR_IO_IPMI.SchDoc]
2013-11-16 PCB with teardrops removed second I2C switch
    [I2C_Switch.SchDoc]
2014-05-19 production version, fixed minor errors
    [RTM_Connectors.SchDoc, RTM_SFP.PrjPcb, RTM_SFP_TOP.SchDoc, SFP.SchDoc, USR_IO_IPMI.SchDoc]
2014-08-06 sch & pcb in pdf
    [Clock_Distribution.SchDoc, I2C_Switch.SchDoc, PWR.SchDoc, RTM_Connectors.SchDoc, RTM_SFP_TOP.SchDoc, SFP.SchDoc, Serial_Registers.SchDoc, USR_IO_IPMI.SchDoc]
2017-02-07 Changed file structure
    [Clock_Distribution.SchDoc, I2C_Switch.SchDoc, PWR.SchDoc, RTM_Connectors.SchDoc, RTM_SFP.PrjPcb, RTM_SFP_TOP.SchDoc, SFP.SchDoc, Serial_Registers.SchDoc]
2017-02-07 Adding project files. Si570 and CDCLVD1212RHAT will be mounted. Resistors R2, R3, R4, R5, R6, R13 changed from 100 ohm to 100k ohm.
    [BOM_RTM_SFP.xls, Clock_Distribution.SchDoc, I2C_Switch.SchDoc, PWR.SchDoc, RTM_Connectors.SchDoc, RTM_SFP.PrjPcb, RTM_SFP_TOP.SchDoc, SFP.SchDoc]
2017-02-07 Fixed serial registers footprint
    Added new component to standard library
    [Serial_Registers.SchDoc]
2017-02-07 Updated project files to new folder structure
    [RTM_SFP.PrjPcb]
2017-02-07 Updated IC11 to a component library standard
    Component IC11 is CDCLVD1212RHA. No function changed
    [Clock_Distribution.SchDoc]
2017-02-07 Updated IC11 footprint, avoided solder over vias
    [Clock_Distribution.SchDoc]
2017-02-07 Updated LM75AIM to standard library
    [USR_IO_IPMI.SchDoc]
2017-02-07 Updated IC14 to standard library
    [USR_IO_IPMI.SchDoc]
2017-02-07 Updated IC39 to standard library
    [I2C_Switch.SchDoc]
2017-02-07 Updated FIN1101 to standard library
    [RTM_Connectors.SchDoc]
2017-02-07 Changed LED17 to standard library
    [USR_IO_IPMI.SchDoc]
2017-02-07 Updated RTM connectors J2, J6 to standard library
    [RTM_Connectors.SchDoc]
2017-02-07 Updated SMA connectores J3, J4 to standard library
    [Clock_Distribution.SchDoc, RTM_Connectors.SchDoc]
2017-02-07 Updated U.FL connectores J12, J13 to standard library
    [Clock_Distribution.SchDoc]
2017-02-07 Changed R211 to 49R9, used standard library
    [RTM_Connectors.SchDoc]
2017-02-07 Corrected 0603 resistors footprint reference
    [Clock_Distribution.SchDoc, PWR.SchDoc, SFP.SchDoc, Serial_Registers.SchDoc, USR_IO_IPMI.SchDoc]
2017-02-07 Corrected 100R part numbers
    [RTM_Connectors.SchDoc]
2017-02-07 Changed 100K resistors to 1%
    [Clock_Distribution.SchDoc, Serial_Registers.SchDoc]
2017-02-07 Added variants for Copper WR and normal optical SFP
    [RTM_SFP.PrjPcb, SFP.SchDoc]
2017-02-07 Added designator to now R29
    [Clock_Distribution.SchDoc]
2017-02-07 Changed 0603 10k resistors to 0402, for consistency
    [SFP.SchDoc]
2017-02-07 Adjusted rules, corrected violations
    [RTM_SFP.PrjPcb]
2017-02-08 Changed capacitors 0603 100nF to 0402
    [PWR.SchDoc]
2017-02-08 Changed capacitors 1206 10uf to 0805
    [PWR.SchDoc]
2017-02-08 Changed capacitors 1 uF 0603 to 10uF 0805
    [PWR.SchDoc]
2017-02-09 Added translator to I2C signals to the schematic
    [RTM_Connectors.SchDoc]
2017-02-10 layouted I2C Signal to PCB
2017-02-14 Corrected BOM variants for optical modules
    [RTM_SFP.PrjPcb, SFP.SchDoc]
2017-06-28 Corrected LEDs footprints. Fixes #4
    [SFP.SchDoc]
2017-06-29 Corrected R6 value. This fixes #5
    [Serial_Registers.SchDoc]
2017-06-29 Fixed IPMI LEDs library
    [USR_IO_IPMI.SchDoc]
2017-06-29 Added I2C voltage options
    [Clock_Distribution.SchDoc, PWR.SchDoc, RTM_Connectors.SchDoc, RTM_SFP.PrjPcb, Serial_Registers.SchDoc]
